holosion/neoguard-ai/pcb/schematic_pages.py.txt

# Three readable sheets; global net labels preserve exact cross-sheet wiring.
main=Page('main','/'+RID)
main.text('AKENA NEOGUARD | LCD SYSTEM INTEGRATION',15,14,2.3,True)
main.text('Electrical pin map matches the 22 October LCD firmware. Module footprints and power ratings require physical confirmation.',15,23,1.15)
main.place('U1',65,140,libname='ESP32_S3_Logical',autolabel=True)
main.text('ESP32-S3 controller',30,65,1.5,True)
main.text('Logical GPIO numbers, not header positions.\nConnect through J1 on the carrier.\nExact devboard socket is not assumed.',20,215,1.15)
for ref,x,y,title in [('J2',185,65,'MAX30102 OXIMETER'),('J3',290,65,'MLX90614 INFRARED'),('J4',385,65,'DS1302 RTC'),('J6',185,130,'SD CARD MODULE'),('J7',290,130,'RGB COMMON CATHODE')]:
    main.text(title,x-35,y-24,1.3,True)
    main.place(ref,x,y,showval=False,autolabel=True)
main.text('Shared I2C: SDA GPIO4, SCL GPIO5.\nSensor headers are functional interfaces.\nReorder cable wires to match purchased modules.',135,91,1.05)
main.text('CR2032: trickle charging disabled in firmware.',330,90,1.0)
for ref,x,y in [('R3',260,175),('R4',305,175),('R5',350,175)]:main.place(ref,x,y,showval=True,autolabel=True)
main.text('Each LED colour has its own 330-ohm resistor.',240,198,1.1)
main.text('BUZZER DRIVER | GPIO15',150,208,1.4,True)
for ref,x,y in [('R6',165,237),('R7',210,237),('Q1',255,237),('D1',305,237),('J8',370,237)]:main.place(ref,x,y,showval=True,autolabel=True)
main.text('PN2222A E1 B2 C3; verify purchased transistor. D1 cathode -> buzzer positive. Driver sized for <=20mA.',145,263,1.0)
main.text('LCD pins GPIO8-13 -> sheet 2. SD stays GPIO21/40/41/42.',125,275,1.1)

LCDSID=uid('lcd-sheet-instance');LCDID=uid('lcd-sheet')
for sid,name,filename,y,page in [(LCDSID,'LCD on carrier','NeoGuard-lcd.kicad_sch',247,2),(SID,'Power and controller cable','NeoGuard-power.kicad_sch',266,3)]:
    main.add(f'(sheet (at 20 {y}) (size 90 12) (stroke (width 0.254) (type default)) (fill (color 0 0 0 0)) (uuid {sid}) (property "Sheetname" "{name}" (at 20 {y-1} 0) {eff(1.05,"left bottom")}) (property "Sheetfile" "{filename}" (at 20 {y+13} 0) {eff(1,"left top")}) (instances (project "NeoGuard" (path "/{RID}" (page "{page}")))))')

lcdpage=Page('lcd','/'+RID+'/'+LCDSID)
lcdpage.text('LCD1602 | PHYSICALLY MOUNTED ON THE CARRIER',15,14,2.3,True)
lcdpage.text('Assumed footprint: WC1602A, 80 x 36 mm, 16 pins at 2.54mm pitch. Verify against the actual display before manufacture.',15,23,1.15)
lcdpage.text('3.3V -> 5V UNIDIRECTIONAL BUFFER',35,45,1.5,True)
lcdpage.place('U2',105,108,showval=False,autolabel=True)
lcdpage.text('U2 MUST be SN74AHCT245N\nSymbol represents the hardwired A -> B direction.\nDo not substitute a 74HC245.\nDIR pin1 = 5V: A -> B.\nOE pin19 = GND: outputs enabled.\nUnused A6/A7 inputs grounded; B6/B7 left open.',25,166,1.15)
lcdpage.text('LCD 16 x 2 | 4-BIT MODE',270,45,1.5,True)
lcdpage.place('J5',310,108,showval=False,autolabel=True)
lcdpage.text('RS=GPIO8   EN=GPIO9\nD4=GPIO10  D5=GPIO11\nD6=GPIO12  D7=GPIO13\n\nRW grounded: ESP32 never reads a 5V bus.\nD0-D3 left unconnected.',263,166,1.15)
for ref,x,y in [('RV1',85,230),('R8',190,230),('C5',280,230),('C6',360,230)]:lcdpage.place(ref,x,y,showval=True,autolabel=True)
lcdpage.text('CONTRAST 10k',50,202,1.3,True)
lcdpage.text('BACKLIGHT 220R',155,202,1.3,True)
lcdpage.text('U2 BYPASS 100nF',250,202,1.3,True)
lcdpage.text('LCD BULK 10uF',330,202,1.3,True)
lcdpage.text('5V is supplied by regulated EXT5V, independent of ESP32 USB power. All grounds common. Power the controller and carrier together.',15,280,1.1)

power=Page('power','/'+RID+'/'+SID)
power.text('POWER SELECTION | CONTROLLER CABLE',15,14,2.3,True)
power.text('No regulator on this carrier. Connect regulated supplies only. Never short external power to a USB-powered ESP32 rail.',15,23,1.15)
for ref,x,y,title in [('J1',70,80,'ESP32-S3 FUNCTIONAL CABLE'),('J9',200,65,'REGULATED INPUT'),('JP1',325,65,'3V3 SOURCE'),('JP2',200,145,'SD SUPPLY'),('JP3',325,145,'BUZZER SUPPLY')]:
    power.text(title,x-35,y-23,1.35,True);power.place(ref,x,y,autolabel=True)
power.text('J1 is not a devboard socket.\nPin22 now carries LCD D7 / GPIO13.\nMap cable wires by GPIO name.\nUSB remains on the external controller.',20,135,1.15)
power.text('J9: 1=EXT3V3, 2=GND, 3=EXT5V\nEXT5V is required for LCD + U2.',160,91,1.1)
power.text('JP1: 1-2 DEV3V3; 2-3 EXT3V3\nOne shunt only. Do not bridge both.',285,91,1.1)
power.text('JP2: 1-2 = 3V3; 2-3 = 5V\nSelect to match the actual SD module.',160,171,1.1)
power.text('JP3: 1-2 = 3V3; 2-3 = 5V\nSelect to match the actual buzzer.',285,171,1.1)
for ref,x in [('C1',40),('C2',95),('C3',150),('C4',205),('R1',285),('R2',365)]:power.place(ref,x,235,showval=True,autolabel=True)
power.text('DECOUPLING: SENSOR 3V3 AND SD SUPPLY',20,207,1.3,True)
power.text('OPTIONAL I2C PULL-UPS',250,207,1.3,True)
power.text('R1/R2 DNP when breakout pull-ups already exist. SDA/SCL must be pulled up to 3.3V, never 5V.',200,265,1.05)

# Explicit power-origin flags for external regulated rails and the selected 3V3 rail.
LIBS['PWR_FLAG']=libsym('power','PWR_FLAG')
for i,net in enumerate(['GND','EXT5V','V3V3','LCD_LED_A']):
    ref='#FLG'+str(i+1)
    CM[ref]={'value':'PWR_FLAG','footprint':'','symbol':'power:PWR_FLAG','pins':{'1':net}}
    power.place(ref,45+i*45,275,libname='PWR_FLAG',autolabel=True)

main.save('NeoGuard.kicad_sch','Akena NeoGuard - LCD System',RID,1)
lcdpage.save('NeoGuard-lcd.kicad_sch','Akena NeoGuard - Mounted LCD and Logic Buffer',LCDID,2)
power.save('NeoGuard-power.kicad_sch','Akena NeoGuard - Power and Controller Cable',CID,3)
(ROOT/'NeoGuard.kicad_sym').write_text('(kicad_symbol_lib (version 20251024) (generator "neoguard_design")\n'+'\n'.join(dump(s) for s in LIBS.values())+'\n)\n',encoding='utf-8')
(ROOT/'sym-lib-table').write_text('(sym_lib_table (version 7) (lib (name "NeoGuard") (type "KiCad") (uri "${KIPRJMOD}/NeoGuard.kicad_sym") (options "") (descr "Akena LCD carrier symbols")))\n')
(ROOT/'schematic_ids.json').write_text(json.dumps({'root_uuid':RID,'paths':PATHS,'symbols':PLACED,'logical_controller':{'reference':'U1','on_board':False,'pin_nets':U1NET}},indent=2))
print('Wrote three-sheet LCD integration schematic.')
