holosion/neoguard-ai/pcb/schematic-1.png

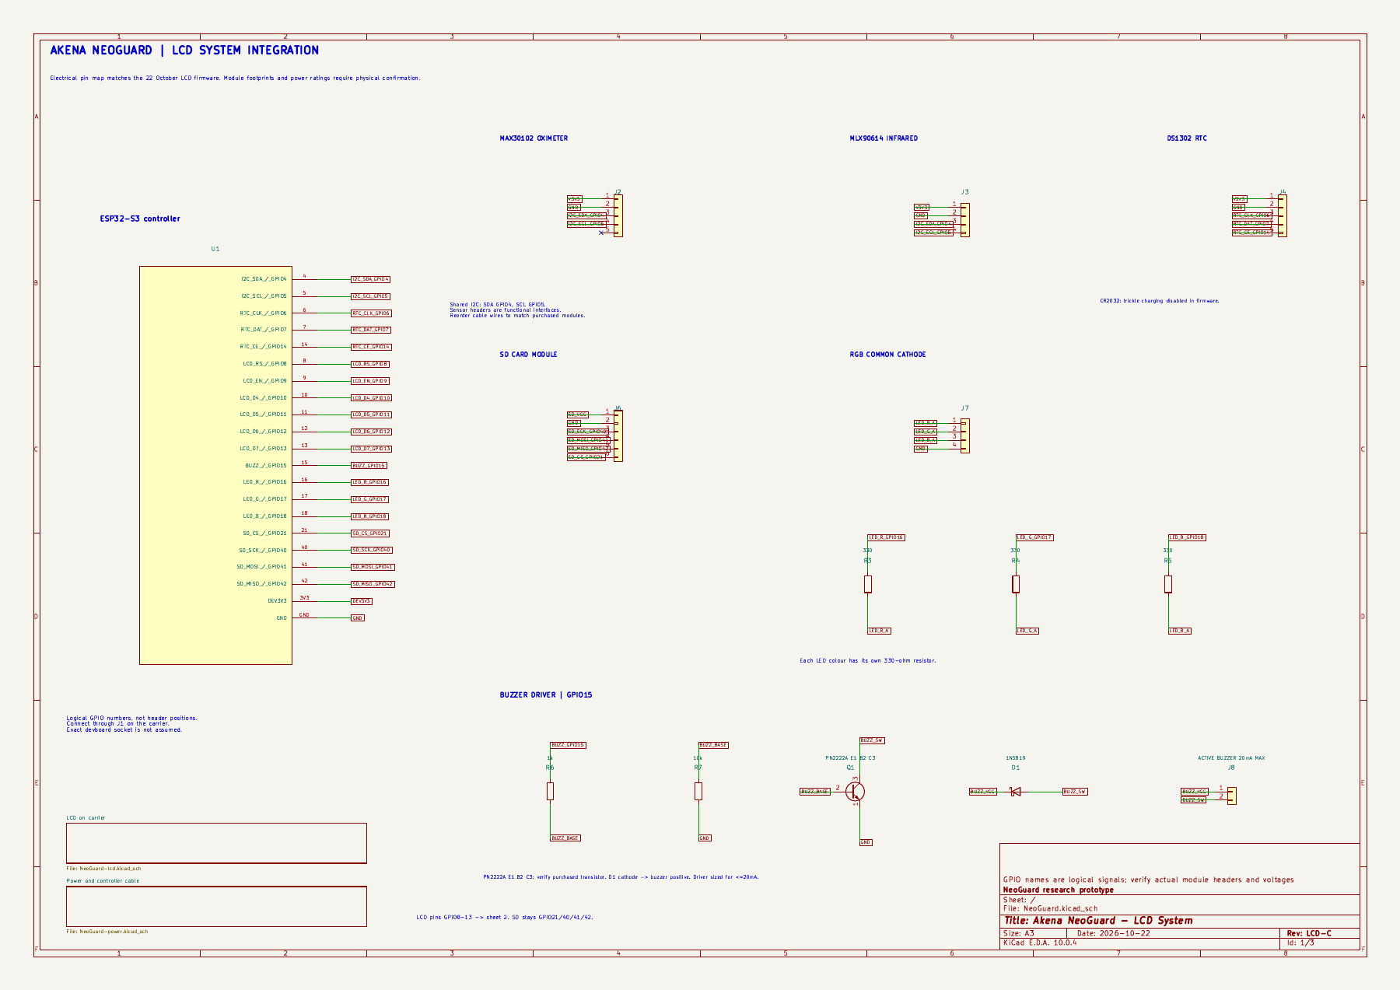
pcb/schematic-1.png
