holosion/neoguard-ai/pcb/schematic-2.png

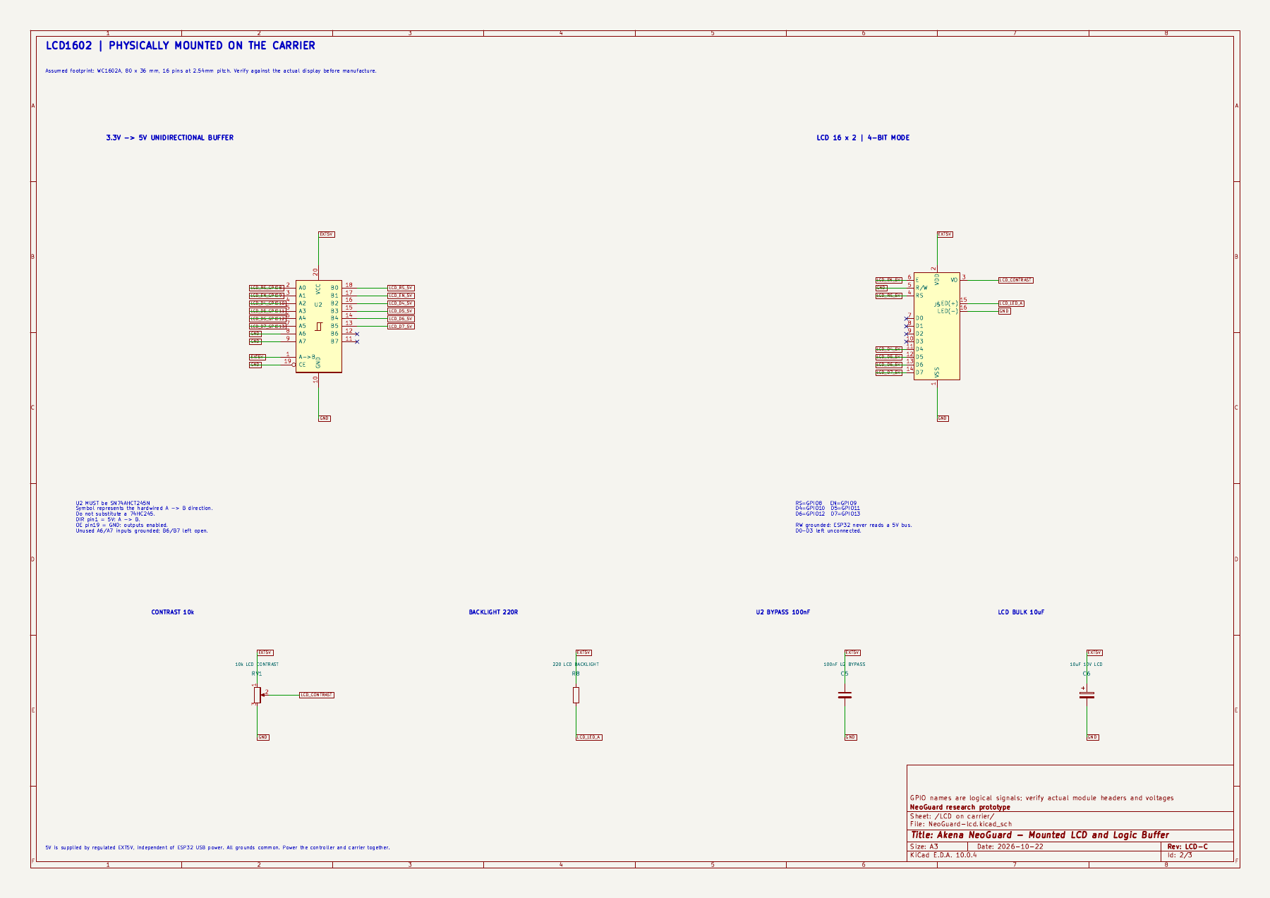
pcb/schematic-2.png
