holosion/neoguard-ai/schematic/ground-plane-preview.png

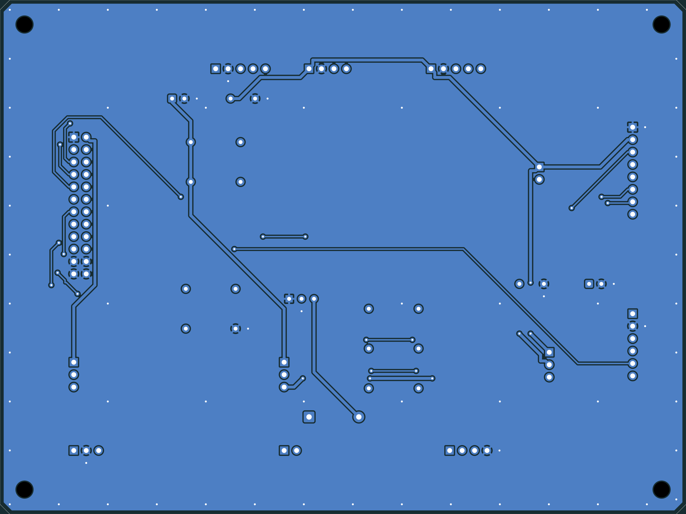
schematic/ground-plane-preview.png
