holosion/neoguard-ai/schematic/revB-review/NeoGuard-Power and carrier harness.png

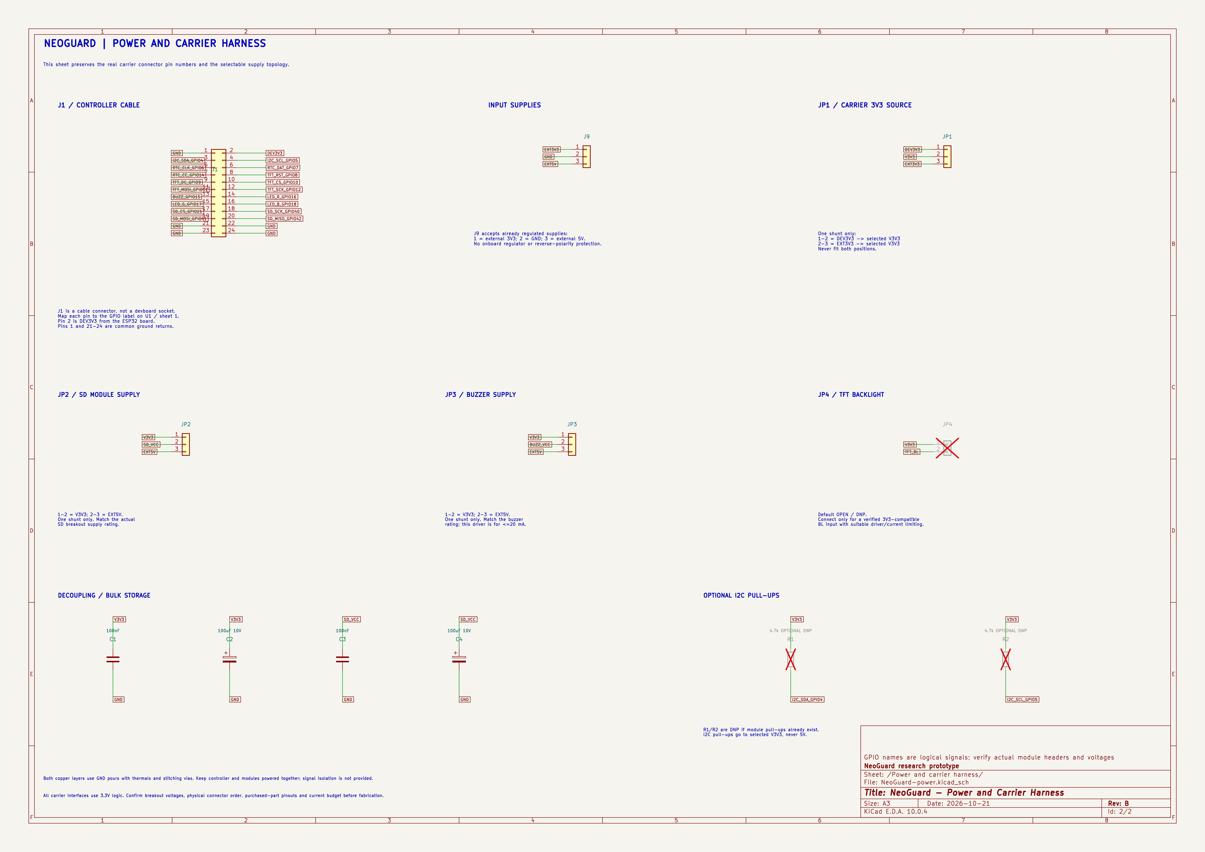
schematic/revB-review/NeoGuard-Power and carrier harness.png
