holosion/neoguard-ai/schematic/revB-review/NeoGuard.png

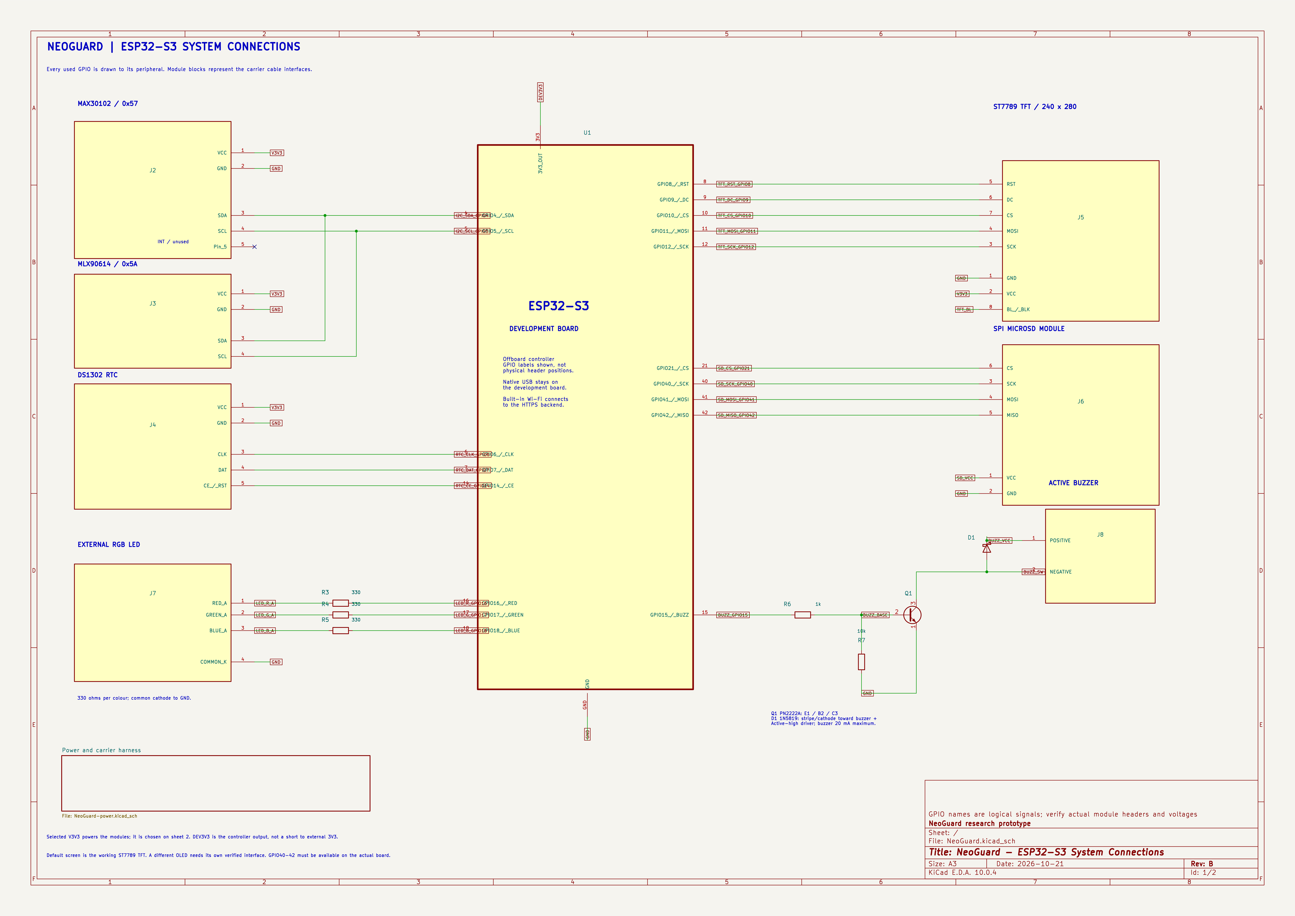
schematic/revB-review/NeoGuard.png
