holosion/neoguard-ai/schematic/tmp/revB-draft-1.png

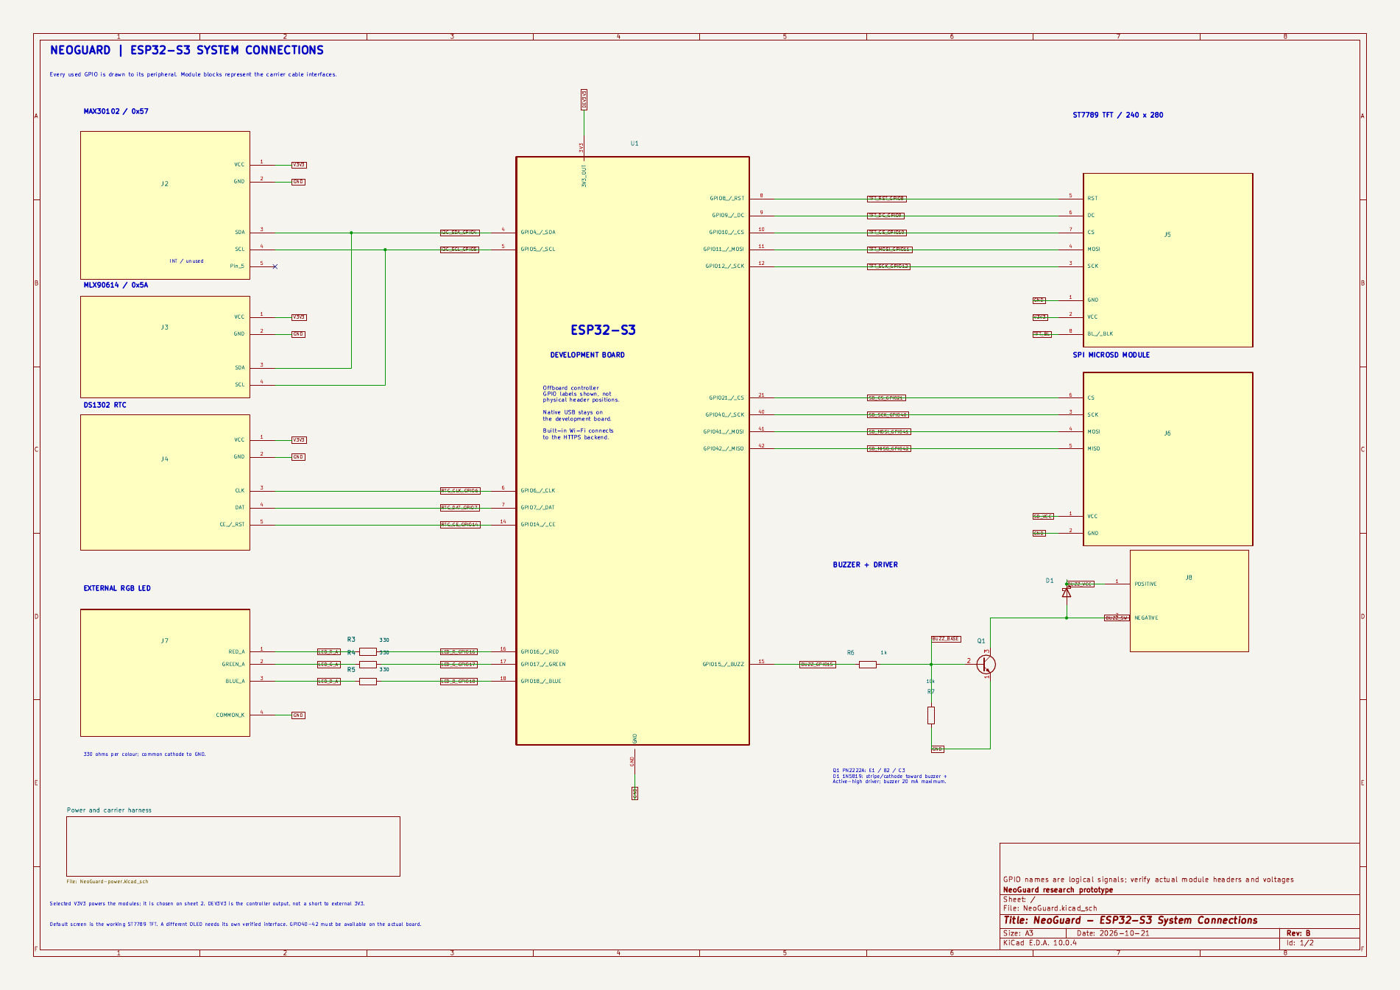
schematic/tmp/revB-draft-1.png
