holosion/neoguard-ai/schematic/Wiring.csv

Connector | Carrier_pin | Net | Connect_to | Notes
J1 | 1 | GND | ESP32-S3 GND (common ground) | Functional cable harness to GPIO labels on the actual ESP32-S3; NOT a devboard socket. Pin 1/21-24 ground. Map physical devboard header separately.
J1 | 2 | DEV3V3 | ESP32-S3 regulated 3V3 output (source option only) | Functional cable harness to GPIO labels on the actual ESP32-S3; NOT a devboard socket. Pin 1/21-24 ground. Map physical devboard header separately.
J1 | 3 | I2C_SDA_GPIO4 | ESP32-S3 GPIO4 | Functional cable harness to GPIO labels on the actual ESP32-S3; NOT a devboard socket. Pin 1/21-24 ground. Map physical devboard header separately.
J1 | 4 | I2C_SCL_GPIO5 | ESP32-S3 GPIO5 | Functional cable harness to GPIO labels on the actual ESP32-S3; NOT a devboard socket. Pin 1/21-24 ground. Map physical devboard header separately.
J1 | 5 | RTC_CLK_GPIO6 | ESP32-S3 GPIO6 | Functional cable harness to GPIO labels on the actual ESP32-S3; NOT a devboard socket. Pin 1/21-24 ground. Map physical devboard header separately.
J1 | 6 | RTC_DAT_GPIO7 | ESP32-S3 GPIO7 | Functional cable harness to GPIO labels on the actual ESP32-S3; NOT a devboard socket. Pin 1/21-24 ground. Map physical devboard header separately.
J1 | 7 | RTC_CE_GPIO14 | ESP32-S3 GPIO14 | Functional cable harness to GPIO labels on the actual ESP32-S3; NOT a devboard socket. Pin 1/21-24 ground. Map physical devboard header separately.
J1 | 8 | TFT_RST_GPIO8 | ESP32-S3 GPIO8 | Functional cable harness to GPIO labels on the actual ESP32-S3; NOT a devboard socket. Pin 1/21-24 ground. Map physical devboard header separately.
J1 | 9 | TFT_DC_GPIO9 | ESP32-S3 GPIO9 | Functional cable harness to GPIO labels on the actual ESP32-S3; NOT a devboard socket. Pin 1/21-24 ground. Map physical devboard header separately.
J1 | 10 | TFT_CS_GPIO10 | ESP32-S3 GPIO10 | Functional cable harness to GPIO labels on the actual ESP32-S3; NOT a devboard socket. Pin 1/21-24 ground. Map physical devboard header separately.
J1 | 11 | TFT_MOSI_GPIO11 | ESP32-S3 GPIO11 | Functional cable harness to GPIO labels on the actual ESP32-S3; NOT a devboard socket. Pin 1/21-24 ground. Map physical devboard header separately.
J1 | 12 | TFT_SCK_GPIO12 | ESP32-S3 GPIO12 | Functional cable harness to GPIO labels on the actual ESP32-S3; NOT a devboard socket. Pin 1/21-24 ground. Map physical devboard header separately.
J1 | 13 | BUZZ_GPIO15 | ESP32-S3 GPIO15 | Functional cable harness to GPIO labels on the actual ESP32-S3; NOT a devboard socket. Pin 1/21-24 ground. Map physical devboard header separately.
J1 | 14 | LED_R_GPIO16 | ESP32-S3 GPIO16 | Functional cable harness to GPIO labels on the actual ESP32-S3; NOT a devboard socket. Pin 1/21-24 ground. Map physical devboard header separately.
J1 | 15 | LED_G_GPIO17 | ESP32-S3 GPIO17 | Functional cable harness to GPIO labels on the actual ESP32-S3; NOT a devboard socket. Pin 1/21-24 ground. Map physical devboard header separately.
J1 | 16 | LED_B_GPIO18 | ESP32-S3 GPIO18 | Functional cable harness to GPIO labels on the actual ESP32-S3; NOT a devboard socket. Pin 1/21-24 ground. Map physical devboard header separately.
J1 | 17 | SD_CS_GPIO21 | ESP32-S3 GPIO21 | Functional cable harness to GPIO labels on the actual ESP32-S3; NOT a devboard socket. Pin 1/21-24 ground. Map physical devboard header separately.
J1 | 18 | SD_SCK_GPIO40 | ESP32-S3 GPIO40 | Functional cable harness to GPIO labels on the actual ESP32-S3; NOT a devboard socket. Pin 1/21-24 ground. Map physical devboard header separately.
J1 | 19 | SD_MOSI_GPIO41 | ESP32-S3 GPIO41 | Functional cable harness to GPIO labels on the actual ESP32-S3; NOT a devboard socket. Pin 1/21-24 ground. Map physical devboard header separately.
J1 | 20 | SD_MISO_GPIO42 | ESP32-S3 GPIO42 | Functional cable harness to GPIO labels on the actual ESP32-S3; NOT a devboard socket. Pin 1/21-24 ground. Map physical devboard header separately.
J1 | 21 | GND | ESP32-S3 GND (common ground) | Functional cable harness to GPIO labels on the actual ESP32-S3; NOT a devboard socket. Pin 1/21-24 ground. Map physical devboard header separately.
J1 | 22 | GND | ESP32-S3 GND (common ground) | Functional cable harness to GPIO labels on the actual ESP32-S3; NOT a devboard socket. Pin 1/21-24 ground. Map physical devboard header separately.
J1 | 23 | GND | ESP32-S3 GND (common ground) | Functional cable harness to GPIO labels on the actual ESP32-S3; NOT a devboard socket. Pin 1/21-24 ground. Map physical devboard header separately.
J1 | 24 | GND | ESP32-S3 GND (common ground) | Functional cable harness to GPIO labels on the actual ESP32-S3; NOT a devboard socket. Pin 1/21-24 ground. Map physical devboard header separately.
J2 | 1 | V3V3 | MAX30102 compatible VIN/VCC | 3.3V-compatible MAX30102 breakout; pin 5/INT deliberately unconnected. Order is carrier functional order, not guaranteed module order.
J2 | 2 | GND | MAX30102 GND | 3.3V-compatible MAX30102 breakout; pin 5/INT deliberately unconnected. Order is carrier functional order, not guaranteed module order.
J2 | 3 | I2C_SDA_GPIO4 | MAX30102 SDA | 3.3V-compatible MAX30102 breakout; pin 5/INT deliberately unconnected. Order is carrier functional order, not guaranteed module order.
J2 | 4 | I2C_SCL_GPIO5 | MAX30102 SCL | 3.3V-compatible MAX30102 breakout; pin 5/INT deliberately unconnected. Order is carrier functional order, not guaranteed module order.
J2 | 5 | NC | No connection; leave MAX INT unconnected | 3.3V-compatible MAX30102 breakout; pin 5/INT deliberately unconnected. Order is carrier functional order, not guaranteed module order.
J3 | 1 | V3V3 | MLX90614 compatible3.3V VIN/VCC | 3.3V-compatible MLX90614 breakout only; 5V variants require a revised supply/level translator.
J3 | 2 | GND | MLX90614 GND | 3.3V-compatible MLX90614 breakout only; 5V variants require a revised supply/level translator.
J3 | 3 | I2C_SDA_GPIO4 | MLX90614 SDA | 3.3V-compatible MLX90614 breakout only; 5V variants require a revised supply/level translator.
J3 | 4 | I2C_SCL_GPIO5 | MLX90614 SCL | 3.3V-compatible MLX90614 breakout only; 5V variants require a revised supply/level translator.
J4 | 1 | V3V3 | DS1302 VCC | Offboard DS1302 module, VCC3.3V; existing CR2032 backup; disable RTC trickle charger.
J4 | 2 | GND | DS1302 GND | Offboard DS1302 module, VCC3.3V; existing CR2032 backup; disable RTC trickle charger.
J4 | 3 | RTC_CLK_GPIO6 | DS1302 CLK/SCLK | Offboard DS1302 module, VCC3.3V; existing CR2032 backup; disable RTC trickle charger.
J4 | 4 | RTC_DAT_GPIO7 | DS1302 DAT/IO | Offboard DS1302 module, VCC3.3V; existing CR2032 backup; disable RTC trickle charger.
J4 | 5 | RTC_CE_GPIO14 | DS1302 CE/RST | Offboard DS1302 module, VCC3.3V; existing CR2032 backup; disable RTC trickle charger.
J5 | 1 | GND | ST7789 GND | ST7789 240x280, 3.3V-compatible breakout; match labels through a harness. Backlight JP4 remains open until verified.
J5 | 2 | V3V3 | ST7789 compatible3.3V VCC | ST7789 240x280, 3.3V-compatible breakout; match labels through a harness. Backlight JP4 remains open until verified.
J5 | 3 | TFT_SCK_GPIO12 | ST7789 SCL/SCK/CLK | ST7789 240x280, 3.3V-compatible breakout; match labels through a harness. Backlight JP4 remains open until verified.
J5 | 4 | TFT_MOSI_GPIO11 | ST7789 SDA/DIN/MOSI (SPI, not I2C) | ST7789 240x280, 3.3V-compatible breakout; match labels through a harness. Backlight JP4 remains open until verified.
J5 | 5 | TFT_RST_GPIO8 | ST7789 RES/RST | ST7789 240x280, 3.3V-compatible breakout; match labels through a harness. Backlight JP4 remains open until verified.
J5 | 6 | TFT_DC_GPIO9 | ST7789 DC/A0 | ST7789 240x280, 3.3V-compatible breakout; match labels through a harness. Backlight JP4 remains open until verified.
J5 | 7 | TFT_CS_GPIO10 | ST7789 CS | ST7789 240x280, 3.3V-compatible breakout; match labels through a harness. Backlight JP4 remains open until verified.
J5 | 8 | TFT_BL | ST7789 BL/BLK only after electrical verification | ST7789 240x280, 3.3V-compatible breakout; match labels through a harness. Backlight JP4 remains open until verified.
J6 | 1 | SD_VCC | SD breakout VIN/VCC (JP2 selected) | SPI microSD breakout, not bare card. Set JP2 for actual module VIN; all signal levels must be 3.3V-compatible.
J6 | 2 | GND | SD breakout GND | SPI microSD breakout, not bare card. Set JP2 for actual module VIN; all signal levels must be 3.3V-compatible.
J6 | 3 | SD_SCK_GPIO40 | SD SCK/CLK | SPI microSD breakout, not bare card. Set JP2 for actual module VIN; all signal levels must be 3.3V-compatible.
J6 | 4 | SD_MOSI_GPIO41 | SD MOSI/DI | SPI microSD breakout, not bare card. Set JP2 for actual module VIN; all signal levels must be 3.3V-compatible.
J6 | 5 | SD_MISO_GPIO42 | SD MISO/DO | SPI microSD breakout, not bare card. Set JP2 for actual module VIN; all signal levels must be 3.3V-compatible.
J6 | 6 | SD_CS_GPIO21 | SD CS/SS | SPI microSD breakout, not bare card. Set JP2 for actual module VIN; all signal levels must be 3.3V-compatible.
J7 | 1 | LED_R_A | RGB red anode through onboard R3=330ohm | External common-cathode RGB LED, with onboard series resistors R3-R5. Verify actual LED lead order.
J7 | 2 | LED_G_A | RGB green anode through onboard R4=330ohm | External common-cathode RGB LED, with onboard series resistors R3-R5. Verify actual LED lead order.
J7 | 3 | LED_B_A | RGB blue anode through onboard R5=330ohm | External common-cathode RGB LED, with onboard series resistors R3-R5. Verify actual LED lead order.
J7 | 4 | GND | RGB common cathode | External common-cathode RGB LED, with onboard series resistors R3-R5. Verify actual LED lead order.
J8 | 1 | BUZZ_VCC | Active buzzer positive (JP3 selected) | Two-pin low-current active buzzer, <=20mA design target; voltage selected by JP3. Verify actual current and Q1 saturation.
J8 | 2 | BUZZ_SW | Active buzzer negative (Q1 switched collector) | Two-pin low-current active buzzer, <=20mA design target; voltage selected by JP3. Verify actual current and Q1 saturation.
J9 | 1 | EXT3V3 | External regulated3.3V supply positive (optional) | Already regulated EXT3V3 pin1, GND pin2, optional EXT5V pin3. No regulator/reverse polarity protection provided.
J9 | 2 | GND | External supply ground; common with ESP32 | Already regulated EXT3V3 pin1, GND pin2, optional EXT5V pin3. No regulator/reverse polarity protection provided.
J9 | 3 | EXT5V | External regulated5V positive (optional) | Already regulated EXT3V3 pin1, GND pin2, optional EXT5V pin3. No regulator/reverse polarity protection provided.
JP1 | 1 | DEV3V3 | DEV3V3 source | One shunt only: 1-2 selects DEV3V3; 2-3 selects EXT3V3. Never bridge both.
JP1 | 2 | V3V3 | Carrier V3V3 load | One shunt only: 1-2 selects DEV3V3; 2-3 selects EXT3V3. Never bridge both.
JP1 | 3 | EXT3V3 | EXT3V3 source | One shunt only: 1-2 selects DEV3V3; 2-3 selects EXT3V3. Never bridge both.
JP2 | 1 | V3V3 | V3V3 source | One shunt only: 1-2 selects 3.3V; 2-3 selects external5V for a verified SD module. Never bridge both.
JP2 | 2 | SD_VCC | SD_VCC load | One shunt only: 1-2 selects 3.3V; 2-3 selects external5V for a verified SD module. Never bridge both.
JP2 | 3 | EXT5V | EXT5V source | One shunt only: 1-2 selects 3.3V; 2-3 selects external5V for a verified SD module. Never bridge both.
JP3 | 1 | V3V3 | V3V3 source | One shunt only: 1-2 selects 3.3V; 2-3 selects external5V for a verified buzzer. Never bridge both.
JP3 | 2 | BUZZ_VCC | BUZZ_VCC load | One shunt only: 1-2 selects 3.3V; 2-3 selects external5V for a verified buzzer. Never bridge both.
JP3 | 3 | EXT5V | EXT5V source | One shunt only: 1-2 selects 3.3V; 2-3 selects external5V for a verified buzzer. Never bridge both.
JP4 | 1 | V3V3 | V3V3 source | DNP/default open. Fit header/shunt only after confirming TFT BL is a 3.3V-compatible input with required limiting/driver.
JP4 | 2 | TFT_BL | TFT_BL backlight feed; open by default | DNP/default open. Fit header/shunt only after confirming TFT BL is a 3.3V-compatible input with required limiting/driver.
