holosion/neoguard-ai/pcb/Connections.csv

Reference | Pin | Net
J1 | 1 | GND
J1 | 2 | DEV3V3
J1 | 3 | I2C_SDA_GPIO4
J1 | 4 | I2C_SCL_GPIO5
J1 | 5 | RTC_CLK_GPIO6
J1 | 6 | RTC_DAT_GPIO7
J1 | 7 | RTC_CE_GPIO14
J1 | 8 | LCD_RS_GPIO8
J1 | 9 | LCD_EN_GPIO9
J1 | 10 | LCD_D4_GPIO10
J1 | 11 | LCD_D5_GPIO11
J1 | 12 | LCD_D6_GPIO12
J1 | 13 | BUZZ_GPIO15
J1 | 14 | LED_R_GPIO16
J1 | 15 | LED_G_GPIO17
J1 | 16 | LED_B_GPIO18
J1 | 17 | SD_CS_GPIO21
J1 | 18 | SD_SCK_GPIO40
J1 | 19 | SD_MOSI_GPIO41
J1 | 20 | SD_MISO_GPIO42
J1 | 21 | GND
J1 | 22 | LCD_D7_GPIO13
J1 | 23 | GND
J1 | 24 | GND
J2 | 1 | V3V3
J2 | 2 | GND
J2 | 3 | I2C_SDA_GPIO4
J2 | 4 | I2C_SCL_GPIO5
J2 | 5 | NO CONNECT
J3 | 1 | V3V3
J3 | 2 | GND
J3 | 3 | I2C_SDA_GPIO4
J3 | 4 | I2C_SCL_GPIO5
J4 | 1 | V3V3
J4 | 2 | GND
J4 | 3 | RTC_CLK_GPIO6
J4 | 4 | RTC_DAT_GPIO7
J4 | 5 | RTC_CE_GPIO14
J5 | 1 | GND
J5 | 2 | EXT5V
J5 | 3 | LCD_CONTRAST
J5 | 4 | LCD_RS_5V
J5 | 5 | GND
J5 | 6 | LCD_EN_5V
J5 | 7 | NO CONNECT
J5 | 8 | NO CONNECT
J5 | 9 | NO CONNECT
J5 | 10 | NO CONNECT
J5 | 11 | LCD_D4_5V
J5 | 12 | LCD_D5_5V
J5 | 13 | LCD_D6_5V
J5 | 14 | LCD_D7_5V
J5 | 15 | LCD_LED_A
J5 | 16 | GND
J6 | 1 | SD_VCC
J6 | 2 | GND
J6 | 3 | SD_SCK_GPIO40
J6 | 4 | SD_MOSI_GPIO41
J6 | 5 | SD_MISO_GPIO42
J6 | 6 | SD_CS_GPIO21
J7 | 1 | LED_R_A
J7 | 2 | LED_G_A
J7 | 3 | LED_B_A
J7 | 4 | GND
J8 | 1 | BUZZ_VCC
J8 | 2 | BUZZ_SW
J9 | 1 | EXT3V3
J9 | 2 | GND
J9 | 3 | EXT5V
JP1 | 1 | DEV3V3
JP1 | 2 | V3V3
JP1 | 3 | EXT3V3
JP2 | 1 | V3V3
JP2 | 2 | SD_VCC
JP2 | 3 | EXT5V
JP3 | 1 | V3V3
JP3 | 2 | BUZZ_VCC
JP3 | 3 | EXT5V
R1 | 1 | V3V3
R1 | 2 | I2C_SDA_GPIO4
R2 | 1 | V3V3
R2 | 2 | I2C_SCL_GPIO5
R3 | 1 | LED_R_GPIO16
R3 | 2 | LED_R_A
R4 | 1 | LED_G_GPIO17
R4 | 2 | LED_G_A
R5 | 1 | LED_B_GPIO18
R5 | 2 | LED_B_A
R6 | 1 | BUZZ_GPIO15
R6 | 2 | BUZZ_BASE
R7 | 1 | BUZZ_BASE
R7 | 2 | GND
Q1 | 1 | GND
Q1 | 2 | BUZZ_BASE
Q1 | 3 | BUZZ_SW
D1 | 1 | BUZZ_VCC
D1 | 2 | BUZZ_SW
C1 | 1 | V3V3
C1 | 2 | GND
C2 | 1 | V3V3
C2 | 2 | GND
C3 | 1 | SD_VCC
C3 | 2 | GND
C4 | 1 | SD_VCC
C4 | 2 | GND
U2 | 1 | EXT5V
U2 | 2 | LCD_RS_GPIO8
U2 | 3 | LCD_EN_GPIO9
U2 | 4 | LCD_D4_GPIO10
U2 | 5 | LCD_D5_GPIO11
U2 | 6 | LCD_D6_GPIO12
U2 | 7 | LCD_D7_GPIO13
U2 | 8 | GND
U2 | 9 | GND
U2 | 10 | GND
U2 | 11 | NO CONNECT
U2 | 12 | NO CONNECT
U2 | 13 | LCD_D7_5V
U2 | 14 | LCD_D6_5V
U2 | 15 | LCD_D5_5V
U2 | 16 | LCD_D4_5V
U2 | 17 | LCD_EN_5V
U2 | 18 | LCD_RS_5V
U2 | 19 | GND
U2 | 20 | EXT5V
RV1 | 1 | EXT5V
RV1 | 2 | LCD_CONTRAST
RV1 | 3 | GND
R8 | 1 | EXT5V
R8 | 2 | LCD_LED_A
C5 | 1 | EXT5V
C5 | 2 | GND
C6 | 1 | EXT5V
C6 | 2 | GND
