holosion/neoguard-ai/pcb/NeoGuard-schematic.pdf

1 | 2 | 3 | 4 | 5 | 6 | 7 | 8

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
Size: A3 | Rev: LCD-C
KiCad E.D.A. 10.0.4 | Id: 1/3 | F Date: 2026-10-22

# Title: Akena NeoGuard - LCD System

### File: NeoGuard.kicad_sch

## Sheet: /

# NeoGuard research prototype

### GPIO names are logical signals; verify actual module headers and voltages

LCD on carrier File: NeoGuard-lcd.kicad_sch Power and controller cable

File: NeoGuard-power.kicad_sch

R4

330 D1

1N5819 R3

330 | R5
| 330

1
2
3
4

J3

DEV3V3 | 3V3
I2C_SDA_/_GPIO4 | | | 4
I2C_SCL_/_GPIO5 | 5 RTC_CLK_/_GPIO6 | 6 RTC_DAT_/_GPIO7 | 7
LCD_RS_/_GPIO8 | 8
LCD_EN_/_GPIO9 | 9
LCD_D4_/_GPIO10 | 10
LCD_D5_/_GPIO11 | 11
LCD_D6_/_GPIO12 | 12
LCD_D7_/_GPIO13 | 13 RTC_CE_/_GPIO14 | 14 BUZZ_/_GPIO15 | 15
LED_R_/_GPIO16 | | | | | | 16
LED_G_/_GPIO17 | | | | | | 17
LED_B_/_GPIO18 | 18 SD_CS_/_GPIO21 | 21 SD_SCK_/_GPIO40 | 40 SD_MOSI_/_GPIO41 | 41 SD_MISO_/_GPIO42 | 42 GND | GND
U1 | 1

2
3
4

J7 1

2

3 Q1

PN2222A E1 B2 C3

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
5/6 J6 | R7
10k | 1

2

J8

ACTIVE BUZZER 20mA MAX

1
2
3
4
5

J4

SD_MOSI_GPIO41

LED_G_A BUZZ_VCC | BUZZ_SW

GND

LCD_D6_GPIO12

LCD_D7_GPIO13 BUZZ_GPIO15

LED_R_GPIO16

LED_G_GPIO17

LED_B_GPIO18

SD_CS_GPIO21

SD_SCK_GPIO40

GND

V3V3 RTC_CLK_GPIO6 RTC_DAT_GPIO7 RTC_CE_GPIO14

LCD_EN_GPIO9

SD_MISO_GPIO42 DEV3V3

I2C_SDA_GPIO4

I2C_SCL_GPIO5

V3V3

V3V3

GND

SD_VCC

GND

SD_SCK_GPIO40

SD_MOSI_GPIO41

SD_MISO_GPIO42

I2C_SDA_GPIO4

SD_CS_GPIO21 RTC_CE_GPIO14

LCD_RS_GPIO8

I2C_SDA_GPIO4

LCD_D4_GPIO10

LCD_D5_GPIO11

I2C_SCL_GPIO5

LED_R_A

LED_G_A

LED_B_A GND

I2C_SCL_GPIO5 RTC_CLK_GPIO6 RTC_DAT_GPIO7 | GND

LED_B_GPIO18

# LED_B_A BUZZ_VCC

LED_R_GPIO16 | BUZZ_SW

LED_R_A

LED_G_GPIO17 BUZZ_GPIO15 BUZZ_BASE | BUZZ_BASE GND | GND
BUZZ_BASE | BUZZ_SW

Logical GPIO numbers, not header positions. Connect through J1 on the carrier. Exact devboard socket is not assumed.

# AKENA NEOGUARD | LCD SYSTEM INTEGRATION

Electrical pin map matches the 22 October LCD firmware. Module footprints and power ratings require physical confirmation. ESP32-S3 controller | Shared I2C: SDA GPIO4, SCL GPIO5. Sensor headers are functional interfaces. Reorder cable wires to match purchased modules. BUZZER DRIVER | GPIO15

## MAX30102 OXIMETER

SD CARD MODULE | MLX90614 INFRARED

PN2222A E1 B2 C3; verify purchased transistor. D1 cathode -> buzzer positive. Driver sized for <=20mA.

## RGB COMMON CATHODE

Each LED colour has its own 330-ohm resistor.

## DS1302 RTC

CR2032: trickle charging disabled in firmware.

LCD pins GPIO8-13 -> sheet 2. SD stays GPIO21/40/41/42.

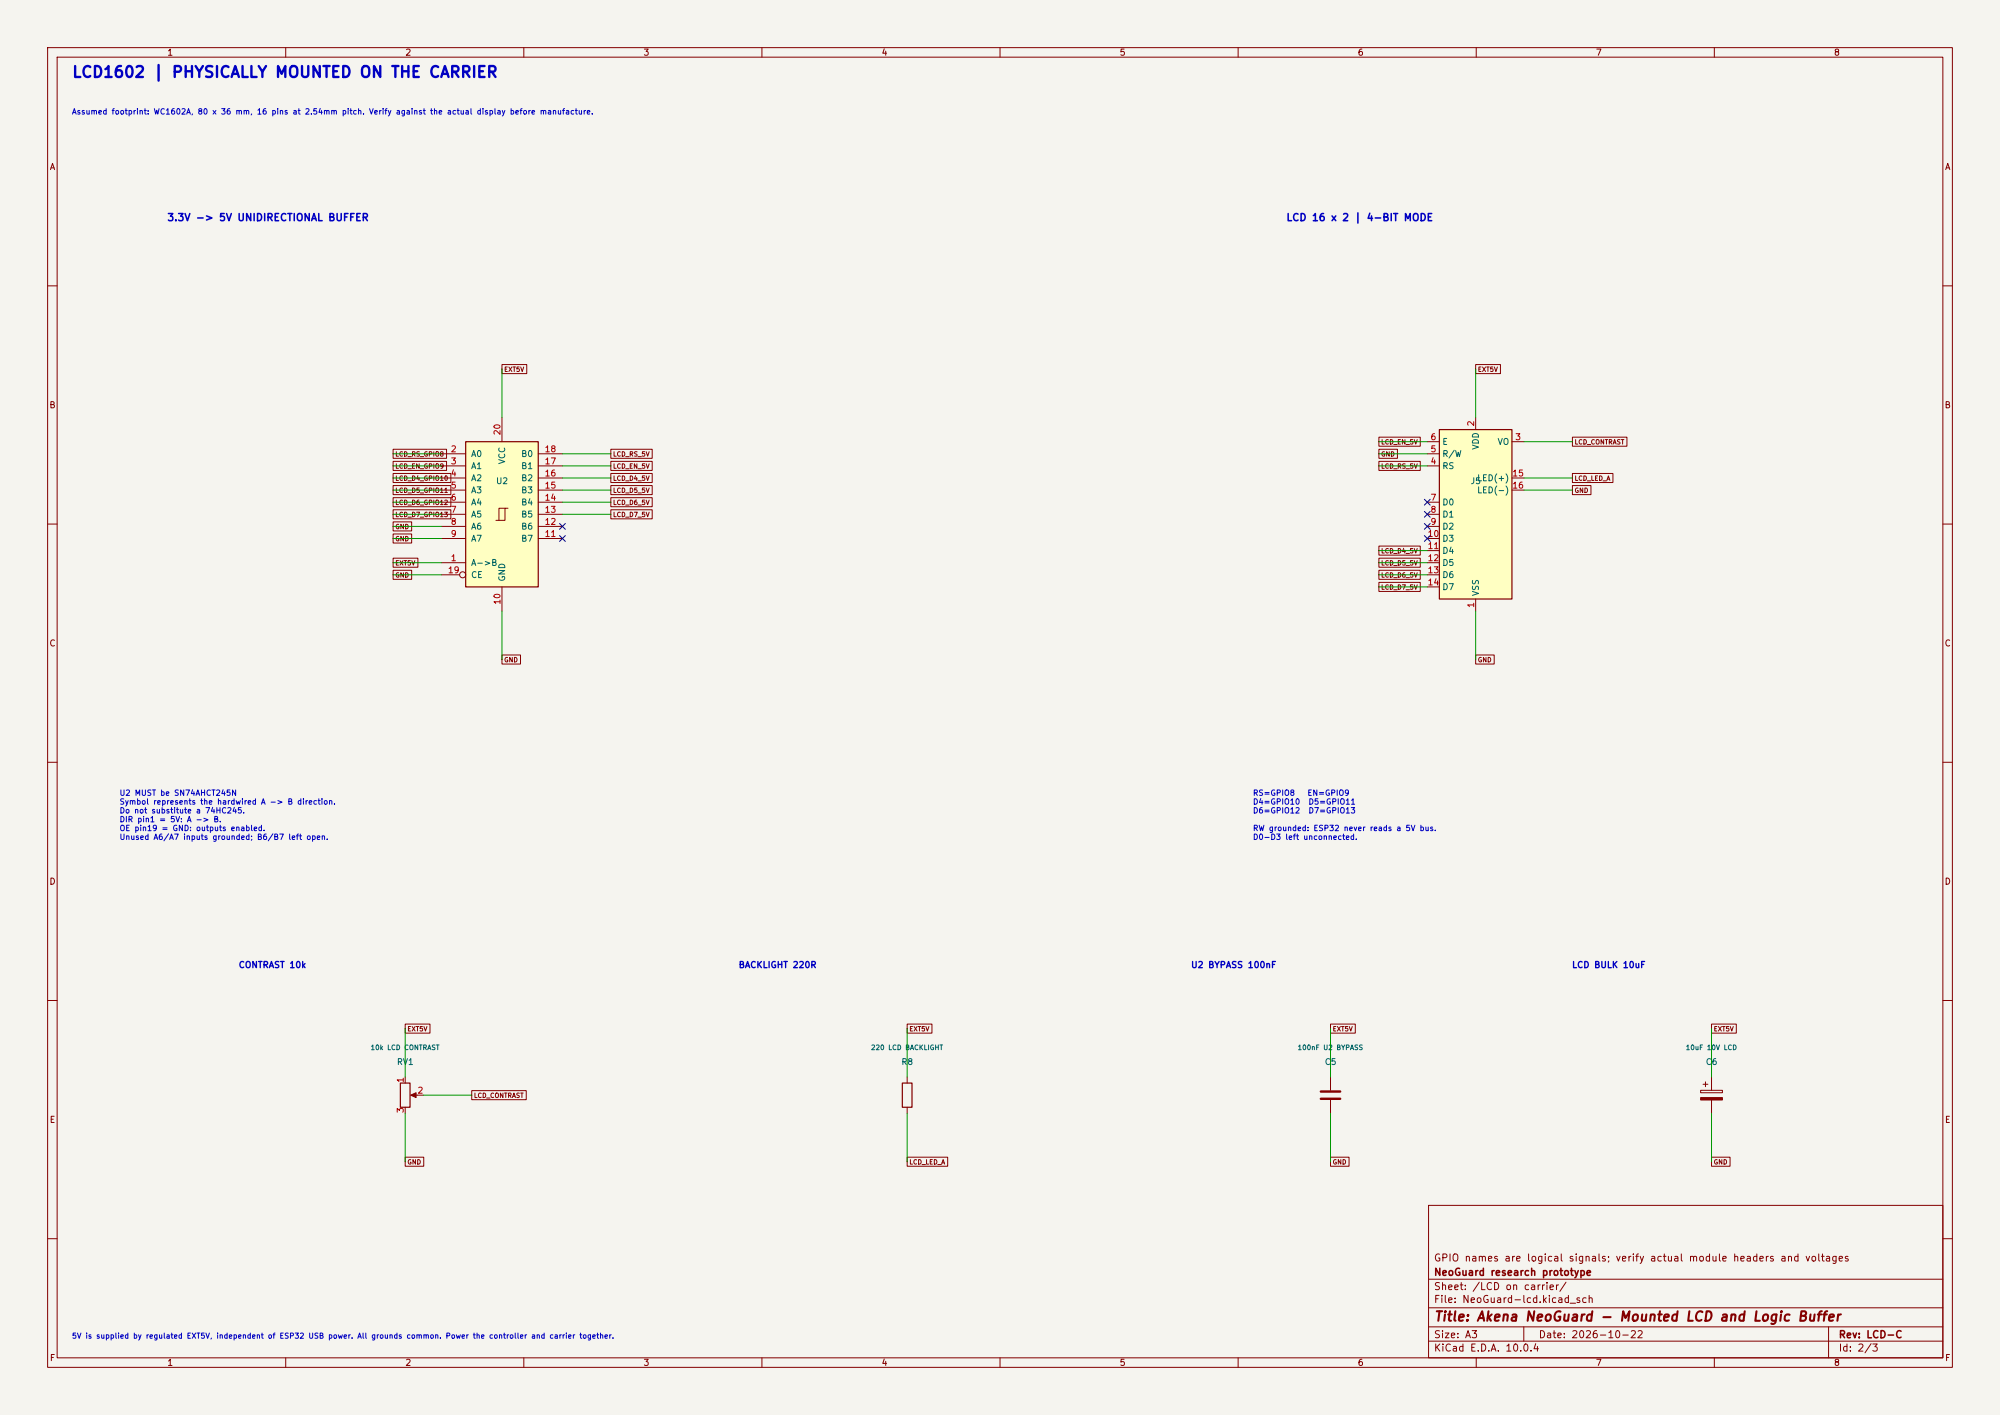
[picture p7: page 2]

LCD1602 | PHYSICALLY MOUNTED ON THE CARRIER

Assumed footprint: WC1602A, 80 x 36 mm, 16 pins at 2.54mm pitch. Verify against the actual display before manufacture.

GPIO names are logical signals; verify actual module headers and voltages VSS

U2 MUST be SN74AHCT245N
Symbol represents the hardwired A -> B direction. Do not substitute a 74HC245. DIR pin1 = 5V: A -> B. OE pin19 = GND: outputs enabled. Unused A6/A7 inputs grounded; B6/B7 left open. CONTRAST 10k

NeoGuard research prototype
Sheet: /LCD on carrier/
File: NeoGuard-lcd.kicad_sch
Title: Akena NeoGuard - Mounted LCD and Logic Buffer

5V is supplied by regulated EXT5V, independent of ESP32 USB power. All grounds common. Power the controller and carrier together.

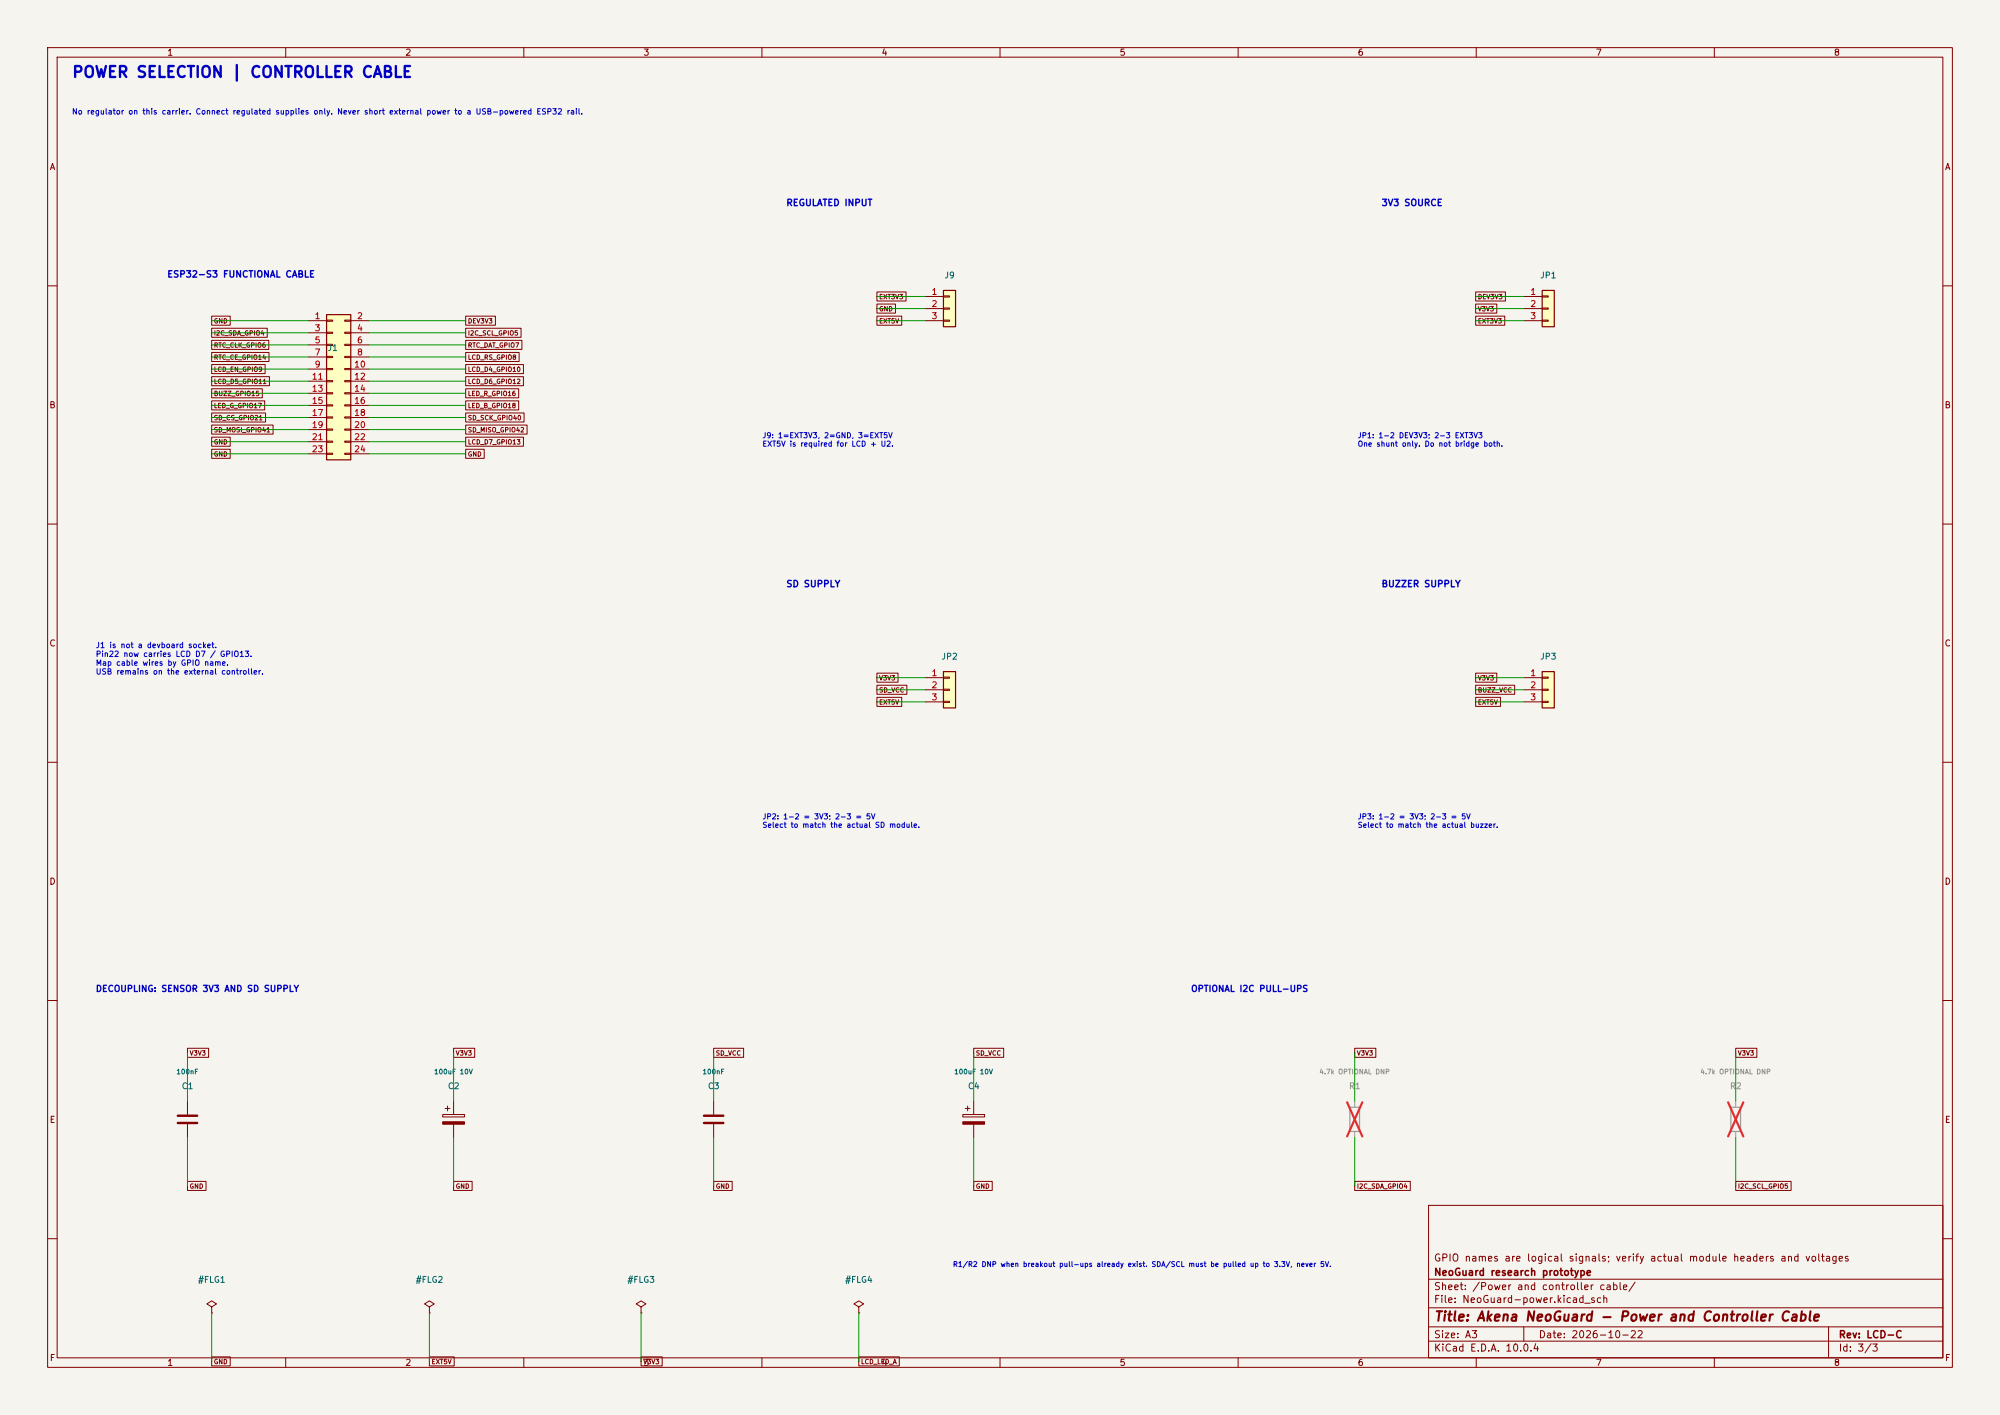
[picture p8: page 3]

POWER SELECTION | CONTROLLER CABLE

R1/R2 DNP when breakout pull-ups already exist. SDA/SCL must be pulled up to 3.3V, never 5V. OPTIONAL I2C PULL-UPS

GPIO names are logical signals; verify actual module headers and voltages
NeoGuard research prototype
Sheet: /Power and controller cable/
File: NeoGuard-power.kicad_sch
Title: Akena NeoGuard - Power and Controller Cable
