holosion/neoguard-ai/schematic/tmp/revB-draft.pdf

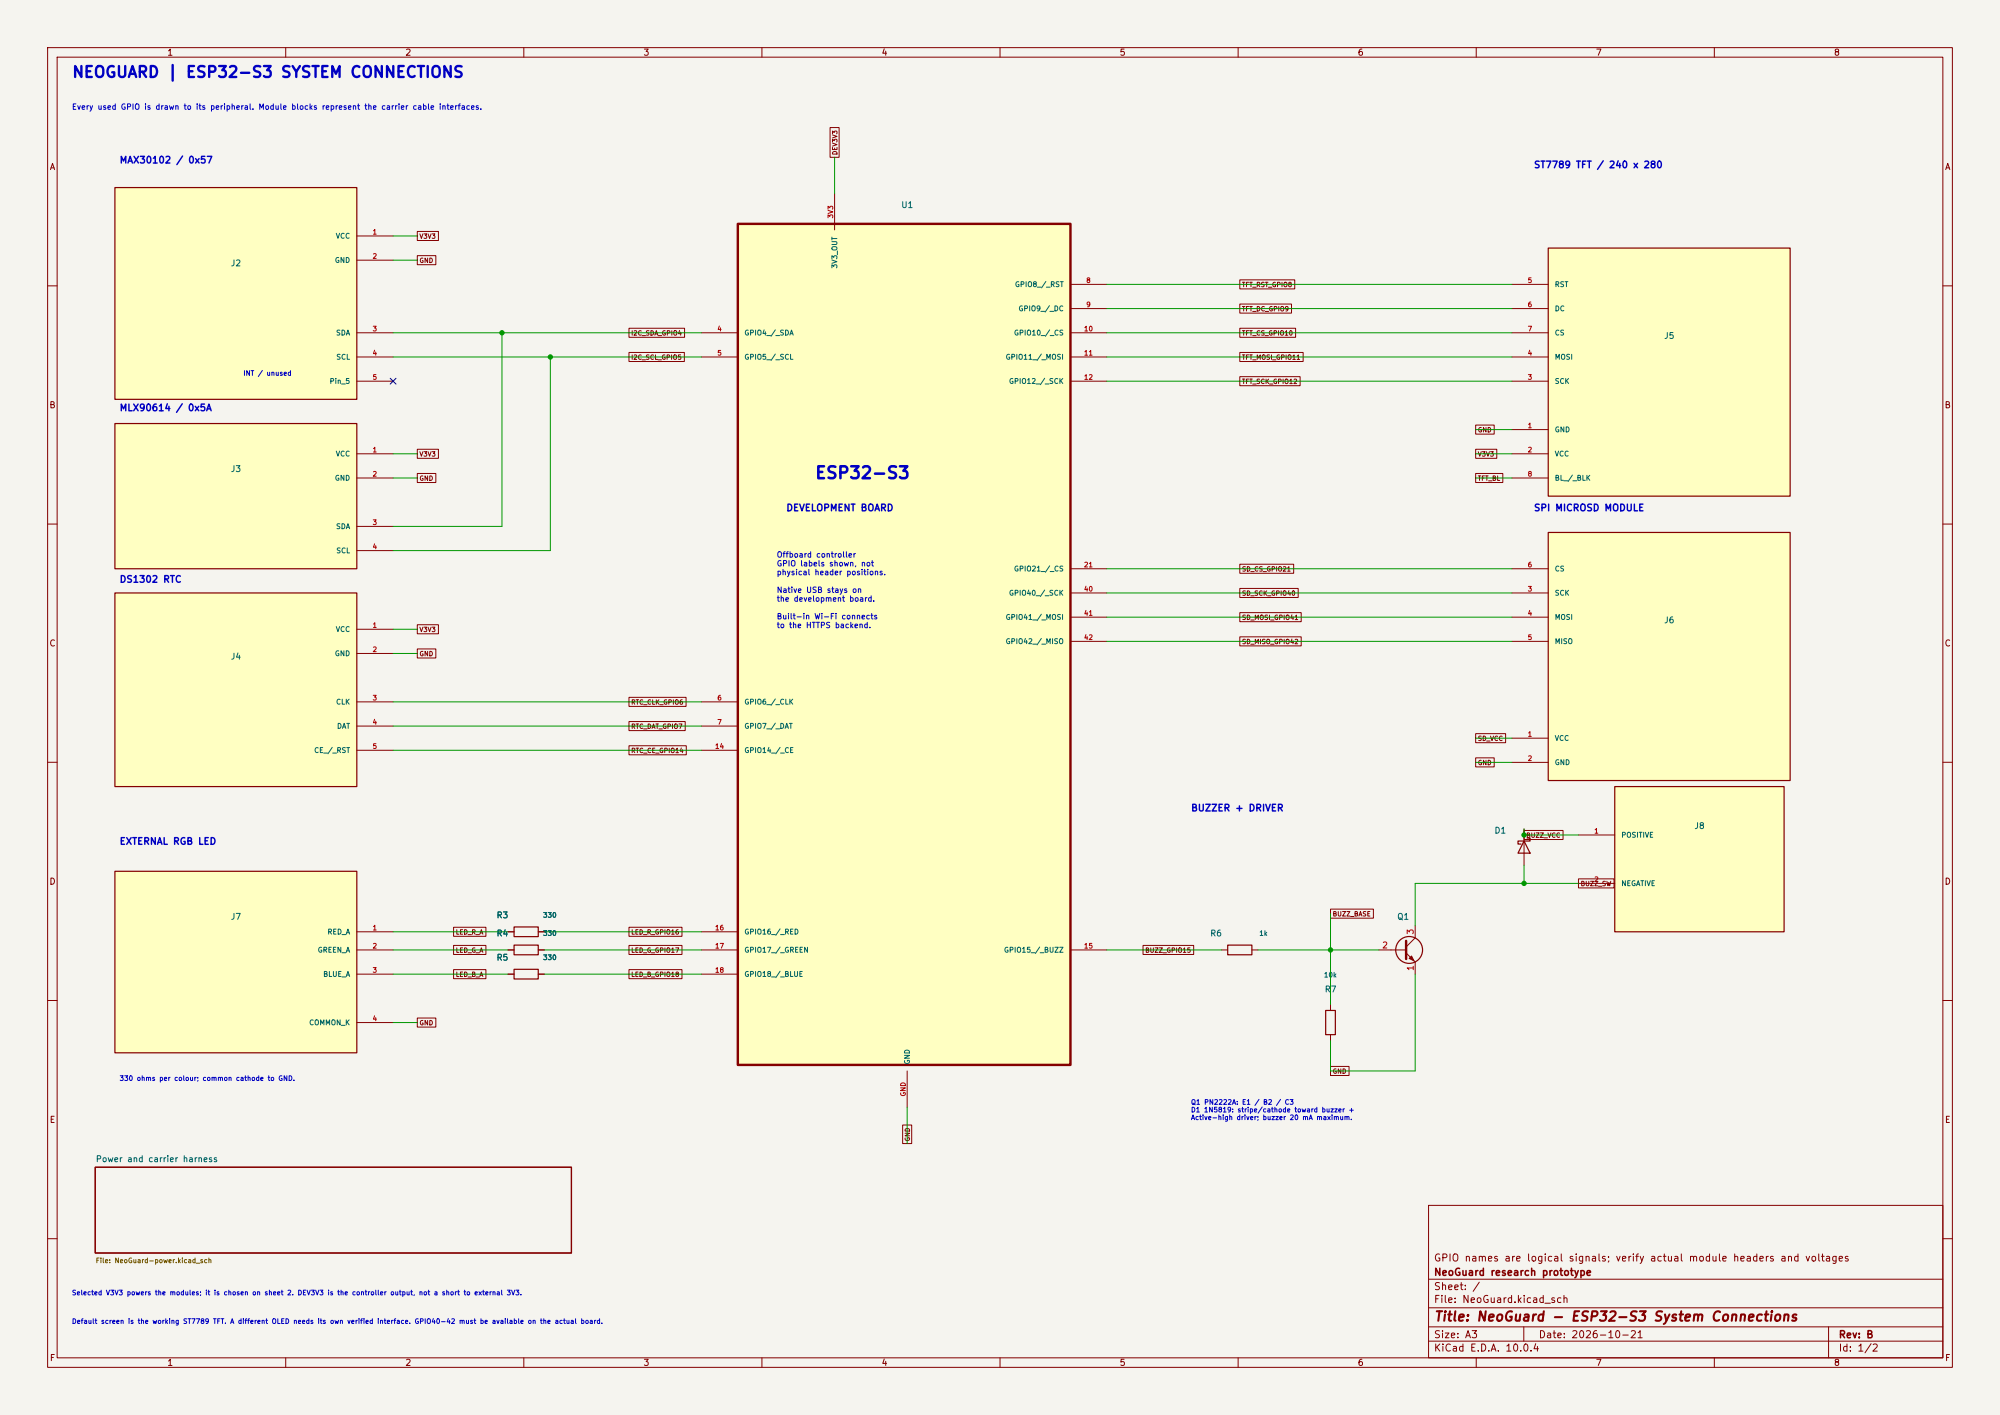
[picture p9: page 1]

Every used GPIO is drawn to its peripheral. Module blocks represent the carrier cable interfaces.

to the HTTPS backend. MLX90614 / 0x5A

Offboard controller GPIO labels shown, not physical header positions. Native USB stays on

the development board. Built-in Wi-Fi connects

330 ohms per colour; common cathode to GND. Selected V3V3 powers the modules; it is chosen on sheet 2. DEV3V3 is the controller output, not a short to external 3V3. Default screen is the working ST7789 TFT. A different OLED needs its own verified interface. GPIO40-42 must be available on the actual board.

Q1 PN2222A: E1 / B2 / C3 D1 1N5819: stripe/cathode toward buzzer +

Active-high driver; buzzer 20 mA maximum.

GPIO names are logical signals; verify actual module headers and voltages Power and carrier harness

NeoGuard research prototype
Sheet: /
File: NeoGuard.kicad_sch
Title: NeoGuard - ESP32-S3 System Connections

Size: A3 | Rev: B | F Date: 2026-10-21
KiCad E.D.A. 10.0.4 | Id: 1/2

1 | 2 | 3 | 4 | 5 | 6 | 7 | 8
1 | 2 | 3 | 4 | 5 | 6 | 7 | 8

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
Size: A3 | Rev: B | F Date: 2026-10-21
KiCad E.D.A. 10.0.4 | Id: 2/2

# Title: NeoGuard - Power and Carrier Harness

## File: NeoGuard-power.kicad_sch

## Sheet: /Power and carrier harness/

## NeoGuard research prototype

## GPIO names are logical signals; verify actual module headers and voltages

1 | 2
3 | 4
5 | 6
7 | 8
9 | 10
11 | 12
13 | 14
15 | 16
17 | 18
19 | 20
21 | 22
23 | 24
J1 | 1

2

JP4

1
2
3
J9 | 1
| 2
| 3

JP1

R2

4.7k OPTIONAL DNP R1

4.7k OPTIONAL DNP 1
2
3

JP3 C2

# 100uF 10V 1

2
3

# JP2 C1

100nF | C4

100uF 10V C3

100nF

TFT_SCK_GPIO12

LED_R_GPIO16

LED_B_GPIO18 RTC_CE_GPIO14

TFT_MOSI_GPIO11

SD_SCK_GPIO40

LED_G_GPIO17

SD_CS_GPIO21

SD_MISO_GPIO42 GND

GND

TFT_BL | V3V3

I2C_SCL_GPIO5 RTC_DAT_GPIO7

TFT_RST_GPIO8

TFT_CS_GPIO10 | BUZZ_VCC

I2C_SCL_GPIO5

BUZZ_GPIO15

V3V3

V3V3

EXT5V

DEV3V3

V3V3

V3V3

DEV3V3

I2C_SDA_GPIO4

EXT5V | EXT3V3

EXT3V3

SD_MOSI_GPIO41 GND

GND

GND

V3V3

SD_VCC

EXT5V

I2C_SDA_GPIO4

V3V3

RTC_CLK_GPIO6

GND

SD_VCC

GND

TFT_DC_GPIO9

SD_VCC

GND

GND

V3V3 GND | OPTIONAL I2C PULL-UPS

## JP3 / BUZZER SUPPLY

J1 is a cable connector, not a devboard socket. Map each pin to the GPIO label on U1 / sheet 1. Pin 2 is DEV3V3 from the ESP32 board. Pins 1 and 21-24 are common ground returns. | JP1 / CARRIER 3V3 SOURCE

Both copper layers use GND pours with thermals and stitching vias. Keep controller and modules powered together; signal isolation is not provided.

## JP2 / SD MODULE SUPPLY

# NEOGUARD | POWER AND CARRIER HARNESS

R1/R2 are DNP if module pull-ups already exist. I2C pull-ups go to selected V3V3, never 5V.

## J1 / CONTROLLER CABLE

One shunt only: 1-2 = DEV3V3 -> selected V3V3

2-3 = EXT3V3 -> selected V3V3 Never fit both positions.

## JP4 / TFT BACKLIGHT

1-2 = V3V3; 2-3 = EXT5V. One shunt only. Match the buzzer

rating; this driver is for <=20 mA.

J9 accepts already regulated supplies: 1 = external 3V3; 2 = GND; 3 = external 5V. No onboard regulator or reverse-polarity protection. 1-2 = V3V3; 2-3 = EXT5V. One shunt only. Match the actual SD breakout supply rating. DECOUPLING / BULK STORAGE

This sheet preserves the real carrier connector pin numbers and the selectable supply topology.

## INPUT SUPPLIES

Default OPEN / DNP. Connect only for a verified 3V3-compatible BL input with suitable driver/current limiting.

All carrier interfaces use 3.3V logic. Confirm breakout voltages, physical connector order, purchased-part pinouts and current budget before fabrication.
