holosion/neoguard-ai/(list of files, drawings)

Other design files:
pcb/schematic_ids.json
schematic/schematic_ids.json
