holosion/neoguard-ai/pcb/NeoGuard.kicad_pcb

## KiCad design pcb/NeoGuard.kicad_pcb (2026-10-22)

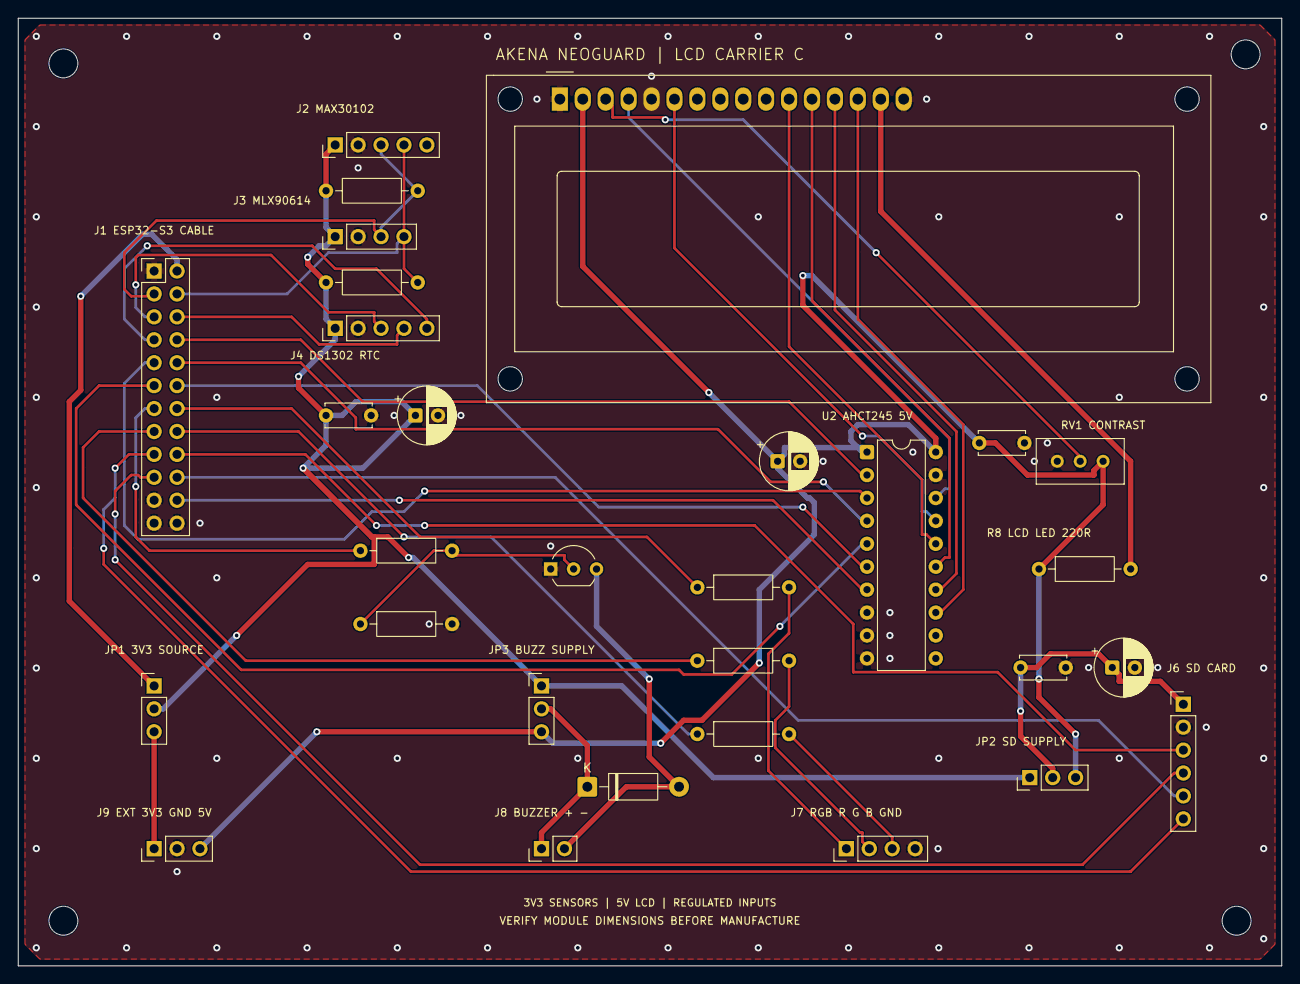
[picture p10: board NeoGuard.kicad_pcb from above]

Board: 2 copper layers, 140.0 x 105.0 mm, 34 parts (0 on the bottom side), 39 nets.

Parts:
C1, C3: 100nF; C_Disc_D5.0mm_W2.5mm_P5.00mm
C2, C4: 100uF 10V; CP_Radial_D6.3mm_P2.50mm
C5: 100nF U2 BYPASS; C_Disc_D5.0mm_W2.5mm_P5.00mm
C6: 10uF 10V LCD; CP_Radial_D6.3mm_P2.50mm
D1: 1N5819; D_DO-41_SOD81_P10.16mm_Horizontal
H1, H2, H3, H4: M3 3.2mm NPTH; MountingHole_3.2mm_M3
J1: ESP32-S3 CABLE - NOT DEVBOARD SOCKET; PinHeader_2x12_P2.54mm_Vertical
J2: MAX30102 BREAKOUT; PinHeader_1x05_P2.54mm_Vertical
J3: MLX90614 3V3 BREAKOUT; PinHeader_1x04_P2.54mm_Vertical
J4: DS1302 MODULE; PinHeader_1x05_P2.54mm_Vertical
J5: WC1602A LCD 16x2 - VERIFY ACTUAL MODULE; LCD1602_80x36_Mounting
J6: SPI MICROSD MODULE; PinHeader_1x06_P2.54mm_Vertical
J7: EXTERNAL RGB COMMON CATHODE; PinHeader_1x04_P2.54mm_Vertical
J8: ACTIVE BUZZER 20mA MAX; PinHeader_1x02_P2.54mm_Vertical
J9: EXTERNAL REGULATED SUPPLIES; PinHeader_1x03_P2.54mm_Vertical
JP1: 3V3 SOURCE - ONE SHUNT; PinHeader_1x03_P2.54mm_Vertical
JP2: SD VOLTAGE - ONE SHUNT; PinHeader_1x03_P2.54mm_Vertical
JP3: BUZZ VOLTAGE - ONE SHUNT; PinHeader_1x03_P2.54mm_Vertical
Q1: PN2222A E1 B2 C3; TO-92_Inline_Wide
R1, R2: 4.7k OPTIONAL DNP; R_Axial_DIN0207_L6.3mm_D2.5mm_P10.16mm_Horizontal
R3, R4, R5: 330; R_Axial_DIN0207_L6.3mm_D2.5mm_P10.16mm_Horizontal
R6: 1k; R_Axial_DIN0207_L6.3mm_D2.5mm_P10.16mm_Horizontal
R7: 10k; R_Axial_DIN0207_L6.3mm_D2.5mm_P10.16mm_Horizontal
R8: 220 LCD BACKLIGHT; R_Axial_DIN0207_L6.3mm_D2.5mm_P10.16mm_Horizontal
RV1: 10k LCD CONTRAST; Potentiometer_Bourns_3296W_Vertical
U2: SN74AHCT245N - NOT 74HC245; DIP-20_W7.62mm

Connections:
BUZZ_BASE: Q1.2, R6.2, R7.1
BUZZ_GPIO15: J1.13, R6.1
BUZZ_SW: D1.2, J8.2, Q1.3
BUZZ_VCC: D1.1, J8.1, JP3.2
DEV3V3: J1.2, JP1.1
EXT3V3: J9.1, JP1.3
EXT5V: C5.1, C6.1, J5.2, J9.3, JP2.3, JP3.3, R8.1, RV1.1, U2.1, U2.20
GND: C1.2, C2.2, C3.2, C4.2, C5.2, C6.2, J1.1, J1.21, J1.23, J1.24, J2.2, J3.2, J4.2, J5.1, J5.5, J5.16, J6.2, J7.4, J9.2, Q1.1, R7.2, RV1.3, U2.8, U2.9, U2.10, U2.19
I2C_SCL_GPIO5: J1.4, J2.4, J3.4, R2.2
I2C_SDA_GPIO4: J1.3, J2.3, J3.3, R1.2
LCD_CONTRAST: J5.3, RV1.2
LCD_D4_5V: J5.11, U2.16
LCD_D4_GPIO10: J1.10, U2.4
LCD_D5_5V: J5.12, U2.15
LCD_D5_GPIO11: J1.11, U2.5
LCD_D6_5V: J5.13, U2.14
LCD_D6_GPIO12: J1.12, U2.6
LCD_D7_5V: J5.14, U2.13
LCD_D7_GPIO13: J1.22, U2.7
LCD_EN_5V: J5.6, U2.17
LCD_EN_GPIO9: J1.9, U2.3
LCD_LED_A: J5.15, R8.2
LCD_RS_5V: J5.4, U2.18
LCD_RS_GPIO8: J1.8, U2.2
LED_B_A: J7.3, R5.2
LED_B_GPIO18: J1.16, R5.1
LED_G_A: J7.2, R4.2
LED_G_GPIO17: J1.15, R4.1
LED_R_A: J7.1, R3.2
LED_R_GPIO16: J1.14, R3.1
RTC_CE_GPIO14: J1.7, J4.5
RTC_CLK_GPIO6: J1.5, J4.3
RTC_DAT_GPIO7: J1.6, J4.4
SD_CS_GPIO21: J1.17, J6.6
SD_MISO_GPIO42: J1.20, J6.5
SD_MOSI_GPIO41: J1.19, J6.4
SD_SCK_GPIO40: J1.18, J6.3
SD_VCC: C3.1, C4.1, J6.1, JP2.2
V3V3: C1.1, C2.1, J2.1, J3.1, J4.1, JP1.2, JP2.1, JP3.1, R1.1, R2.1
