holosion/neoguard-ai/akena firmware/akena_firmware/root_ca.h

#pragma once
static const char ROOT_CA[] PROGMEM = R"CERT(-----BEGIN CERTIFICATE-----
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
HMUfpIBvFSDJ3gyICh3WZlXi/EjJKSZp4A==
-----END CERTIFICATE-----
)CERT";
