holosion/neoguard-ai/(commit log)

2026-10-06 Build NeoGuard backend scaffold and archive-aware data model
    - Add FastAPI, PostgreSQL, SQLAlchemy, and Alembic configuration
    - Add staff/device authentication, patient, device, session, sync, alert, and admin APIs
    - Add idempotent device readings, threshold alerts, and audit logging
    - Separate research dataset imports and observations from live clinical readings
    - Document archive contents, data quality issues, and storage mappings
    - Add local PostgreSQL setup and admin bootstrap instructions
2026-10-06 Set up PostgreSQL database and verify backend migration pipeline
    - Create the neoguard database and apply the initial Alembic migration
    - Seed the admin account and provisional alert thresholds
    - Add a live API smoke flow for login, sync, deduplication, readings, and alerts
    - Configure local backend environment and development dependencies
    - Document database setup and migration verification
2026-10-06 feat(backend): harden authentication, device sync, and session integrity feat(database): add AI model and outcome provenance foundations test(backend): expand PostgreSQL smoke coverage for security a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
2026-10-09 Implement synthetic risk model training and scoring system
    - Added `train.py` for training a synthetic warning prototype and isolated source-label benchmark.
    - Introduced feature extraction logic in `risk_features.py` for consistent feature handling in training and serving.
    - Developed model loading and prediction functions in `risk_model.py` to handle logistic regression model inference.
    - Created `risk.py` to persist experimental risk scores and manage model configurations.
    - Implemented database migrations to enforce session and reading relationships.
    - Added integration tests for risk scoring and session management in `test_postgres_integration.py`.
    - Created unit tests for feature extra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
2026-10-12 Add display message functionality for ESP32-S3 and LCD integration
2026-10-12 feat: consolidate frontend and connect clinic-scoped backend
    - Replace prototype frontends with the integrated React app
    - Connect frontend views to live API and database data
    - Add clinic-scoped routes, access requests, and schema migration
    - Update local startup and setup documentation
2026-10-13 feat(auth): add temporary password lifecycle and clinic-scoped access
    Add password expiry and forced-change handling, token version invalidation,
    and role-aware access controls for clinical data.
    feat(dashboard): add dynamic dark-mode admin and clinician views
    Build dashboards around live API data, with KPI cards, charts, patient trends,
    and updated navigation.
    style(auth): redesign login page and clear expired-session notices
    Apply the dark split-screen design and make the sign-in-expired notice
    dismiss after it is shown.
    feat(dev): start the local app stack with FastAPI
    Add local startup support and documentation for running the API, frontend,
    and PostgreSQL-backed project together.
    t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
2026-10-13 Created a detailed project guide at [README.md](C:/Users/okuja/Desktop/neoguard-ai/README.md). It covers the architecture, setup and startup, frontend/backend/database data flow, API areas, security,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
2026-10-22 chore: save current project work
2026-10-24 Add lock files for PCB project NeoGuard
    - Created new lock files: pcb~NeoGuard.kicad_pcb.lck and pcb~NeoGuard.kicad_pro.lck
    - Lock files contain hostname and username information for project management
